newaetech/chipwhisperer-husky/(threads)

Thread 7 (2025-02-27):

GLITCH_HP performance

lujji, 2025-02-27:
I'm trying to figure out why HP glitch has almost no effect on my targets. I probed signals on gate resistors R93 and R88 respectively.

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

5MHz on R93 (GLITCHLP) looks ok:
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

However on R88 the signal is quite distorted:
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

At higher frequencies it is completely unusable:
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

It seems that FPGA doesn't have enough juice to drive the gate of the high-power mosfet. Perhaps a gate-driver is required, or at least connecting a few IOs in parallel?

jpcrypt, 2025-02-27:
The HP MOSFET will take longer to switch, by definition. This will also depend on your target. This is why we have both LP and HP, to give you flexibility. Note that you can also turn both of them on simultaneously. If you drive the glitch long enough then you should see it fully turn on.

jpcrypt, 2025-02-27:
Also FYI some of this is discussed here: https://eprint.iacr.org/2016/810.pdf, and in the [Hardware Hacking Handbook](https://nostarch.com/hardwarehacking).

Thread 8 (2025-02-27):

UART trigger bug

lujji, 2025-02-27:
I'm trying to trigger on UART pattern [0x11, 0xee] (STM32 bootloader Read command).

Setup:
``` python
import chipwhisperer as cw

scope = cw.scope(name='Husky')
scope.default_setup()

scope.io.tio1 = 'serial_tx'
scope.io.tio2 = 'serial_rx'
scope.io.pdic = 'high'
scope.scopetype.usart.init(38400, 1, 'even')
scope.scopetype.usart.timeout = 2000

scope.trigger.module = 'UART'
scope.trigger.triggers = 'tio1' # tx
scope.UARTTrigger.enabled = True
scope.UARTTrigger.baud = scope.scopetype.usart._baud
scope.UARTTrigger.set_pattern_match(0, [0x11], mask=[0xff])
scope.UARTTrigger.trigger_source = 0
scope.UARTTrigger.rules_enabled = [0]

scope.gain.db = 12
scope.adc.samples = 1024
scope.adc.presamples = 0
scope.adc.lo_gain_errors_disabled = True
```

Test code:
``` python
# scope.scopetype.usart.flush()
scope.arm()
scope.scopetype.usart.write([0x11, 0xee])
scope.capture()
print(scope.UARTTrigger.matched_pattern_counts)
```

This works perfectly fine, however if I change the pattern to `[0xee]` in `set_pattern_match()` all of a sudden trigger stops working and I start getting timeouts!
```
(ChipWhisperer Scope WARNING|File _OpenADCInterface.py:732) Timeout in OpenADC capture(), no trigger seen! Trigger forced, data is invalid. Status: 13
(ChipWhisperer Scope WARNING|File _OpenADCInterface.py:732) Timeout in OpenADC capture(), no trigger seen! Trigger forced, data is invalid. Status: 12
```

jpcrypt, 2025-02-27:
It works for me (with no target attached).

My guess is that you have a target attached, but you've reversed the tio1/tio2 directions -- for our targets, tio1 is Tx and tio2 is Rx. So you may have contention on the tio1 line. You could confirm with a logic analyzer.

Re-open the issue if I'm wrong.

lujji, 2025-02-28:
@jpcrypt target is a custom board where TX is indeed routed to tio1. However, since I'm triggering from TX I believe the target board is irrelevant. I have just disconnected everything from the husky and running the code from the above with pattern set to `0xee` always results in a timeout.

lujji, 2025-02-28:
Checked with a scope on tio1 just to make sure - serial data is being generated as expected. It seems like there's something special about the 0xEE byte..
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

jpcrypt, 2025-02-28:
> edit: I think I've narrowed it down to parity setting - when parity is set to 'even' it breaks UART trigger

No- it's because by default, the `UARTTrigger` module is set to "no parity":
```
>>> print(scope.UARTTrigger)
enabled                = True
baud                   = 38432.64699673976
data_bits              = 8
stop_bits              = 1
parity                 = none
accept_parity_errors   = False
sampling_clock         = 39764270.7824707
trigger_source         = rule #0
rules_enabled          = [0]
rules                  = [{'rule': 0, 'patt': bytearray(b'\x00\x00\x00\x00\x00\x00\x00\x11'), 'mask': bytearray(b'\x00\x00\x00\x00\x00\x00\x00\xff')}]
matched_pattern_counts = [15, 0, 0, 0, 0, 0, 0, 0]
```
You need to set `scope.UARTTrigger.parity` to 'even'.
(alternatively, set `scope.UARTTrigger.accept_parity_errors = True` and parity will be ignored)

lujji, 2025-02-28:
Ah, I see, `UARTTrigger` has it's own parity setting independent of built-in usart - now it works as expected, thank you!

jpcrypt, 2025-02-28:
They are 100% independent and unaware of each other -- that's a feature, not a bug, to better support the general case i.e. triggering on UART traffic where Husky is neither the sender nor the receiver.

Closed 2025-02-27.

Thread 9 (2025-03-07):

CW functionality in MPSSE mode

lujji, 2025-03-07:
Is it possible to use chipwhisperer functionality in MPSSE mode while debugging the target ? This is what I've tried so far:

```
scope = cw.scope(name='Husky')
scope.enable_MPSSE(1, husky_userio='jtag') # 'swd' does not work
scope.dis()
```
At this point I can connect to the target via openocd, however after reconnecting to husky with `scope = cw.scope(name='Husky')` openocd can no longer connect to target:
```
Open On-Chip Debugger 0.12.0
Licensed under GNU GPL v2
For bug reports, read
        http://openocd.org/doc/doxygen/bugs.html
none separate

Info : FTDI SWD mode enabled
swd
Info : Listening on port 6666 for tcl connections
Info : Listening on port 4444 for telnet connections
Info : clock speed 2000 kHz
Error: Error connecting DP: cannot read IDR
```
The documentation lists some of the [limitations](https://chipwhisperer.readthedocs.io/en/latest/debugging.html#feature-limitations) in MPSSE mode, however from what I understand they are only related to certain IOs and stream mode.

colinoflynn, 2025-03-07:
Are you running this on Windows by chance? That has an additional [limitation](https://chipwhisperer.readthedocs.io/en/latest/debugging.html#windows-specific-limitations) that only one process can attach at a time.

Otherwise I think you *shouldn't* disconnect:
```
scope.dis()
```

This is required on Windows due to the limitation. Alex can confirm however as it's been a while since I ran this, but wanted to check on the Windows question first as that would be the limitation of the OS here.

lujji, 2025-03-07:
I'm running on linux. Tried without calling `scope.dis()` - same result.

alex-dewar, 2025-03-07:
I remember this working at one point, but this might've been broken when fixing something else. I probably won't have time to look into this for quite a while, so I'm going to update the documentation to note that simultaneous use of CW and MPSSE might not work.

colinoflynn, 2025-03-07:
I don't remember 100% if I ever did it either - the main use case of MPSSE was for programming targets w/o bootloaders, and not simultaneous debugging. From memory the timing could be tricky.

What target is this on too?

lujji, 2025-03-07:
Target is stm32f4 (custom board), swd connected as follows:
```
SWDIO -> JTAG_TMS
SWCLK -> JTAG_TCK
```

Newer revision of factory bootloader has multiple places where it checks for readout protection and I'm trying to figure out the timings for the attack by setting multiple breakpoints and analyzing power traces.

I had the same "cannot read IDR" error when I tried setting `husky_userio='swd'` instead of `jtag`  - something weird was happening on SWDIO line when device was replying to SWD commands.

lujji, 2025-03-07:
Ok, I think I found a solution - calling `scope.io.cwe.setAVRISPMode(1)` after re-connecting to husky seems to fix SWD.

Closed 2025-03-08.
