newaetech/chipwhisperer-husky/schematic/NAE-CWLITE-HUSKY-03.PDF

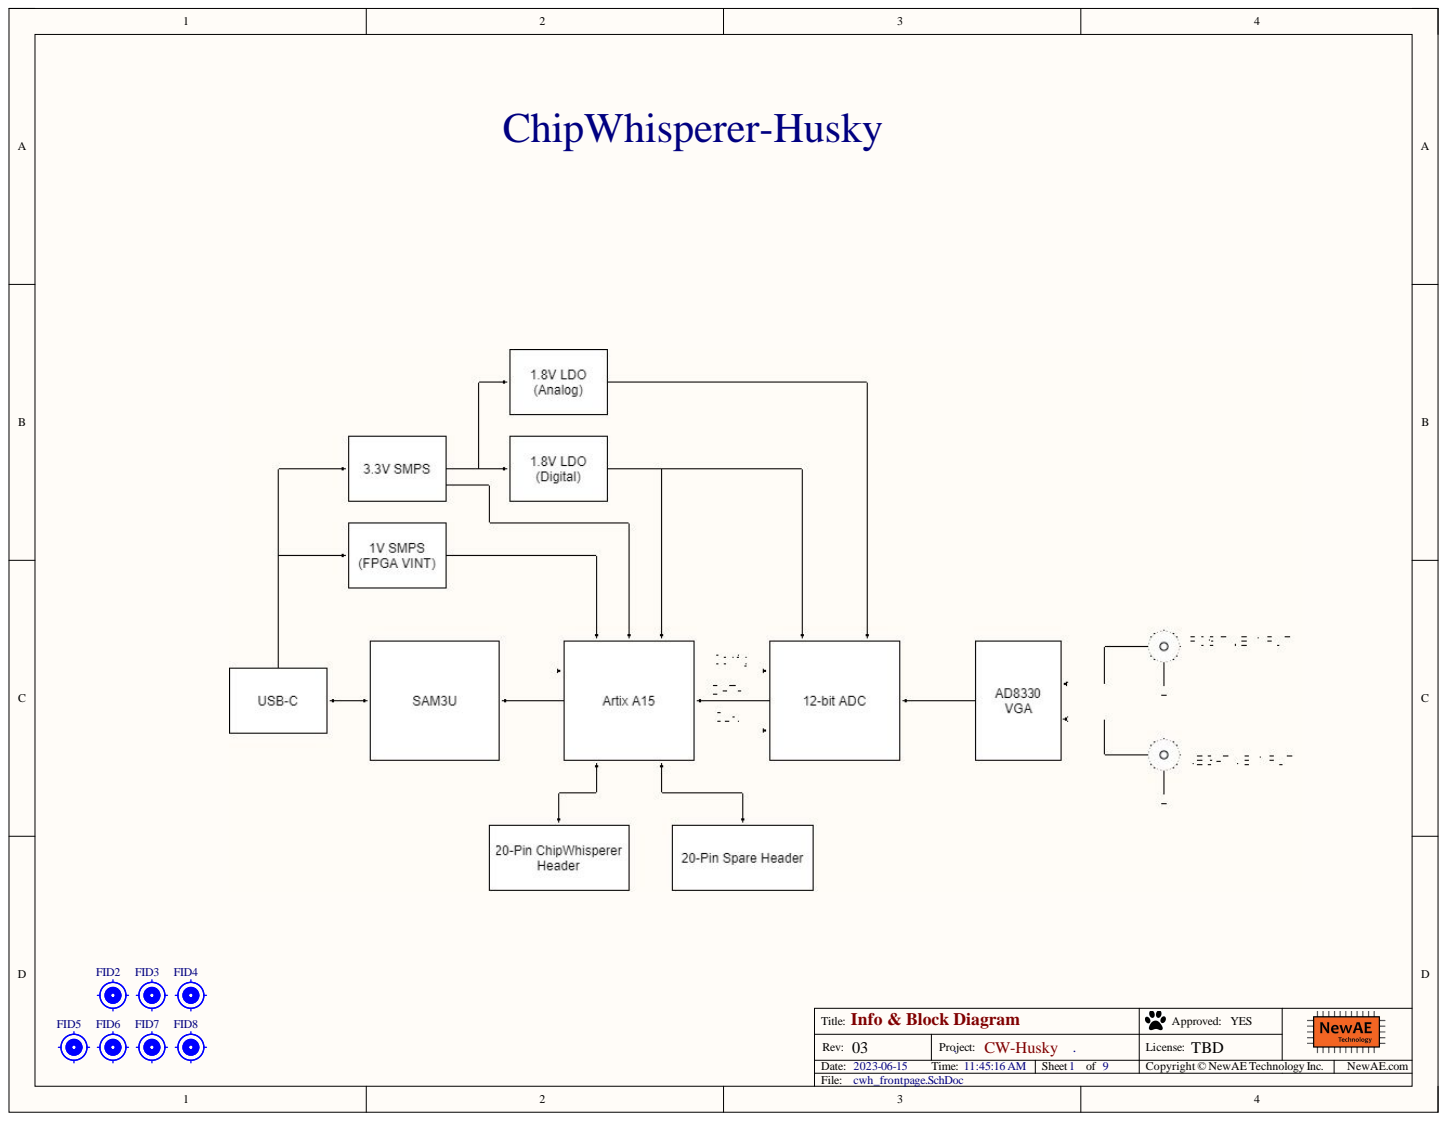
[picture p2: page 1]

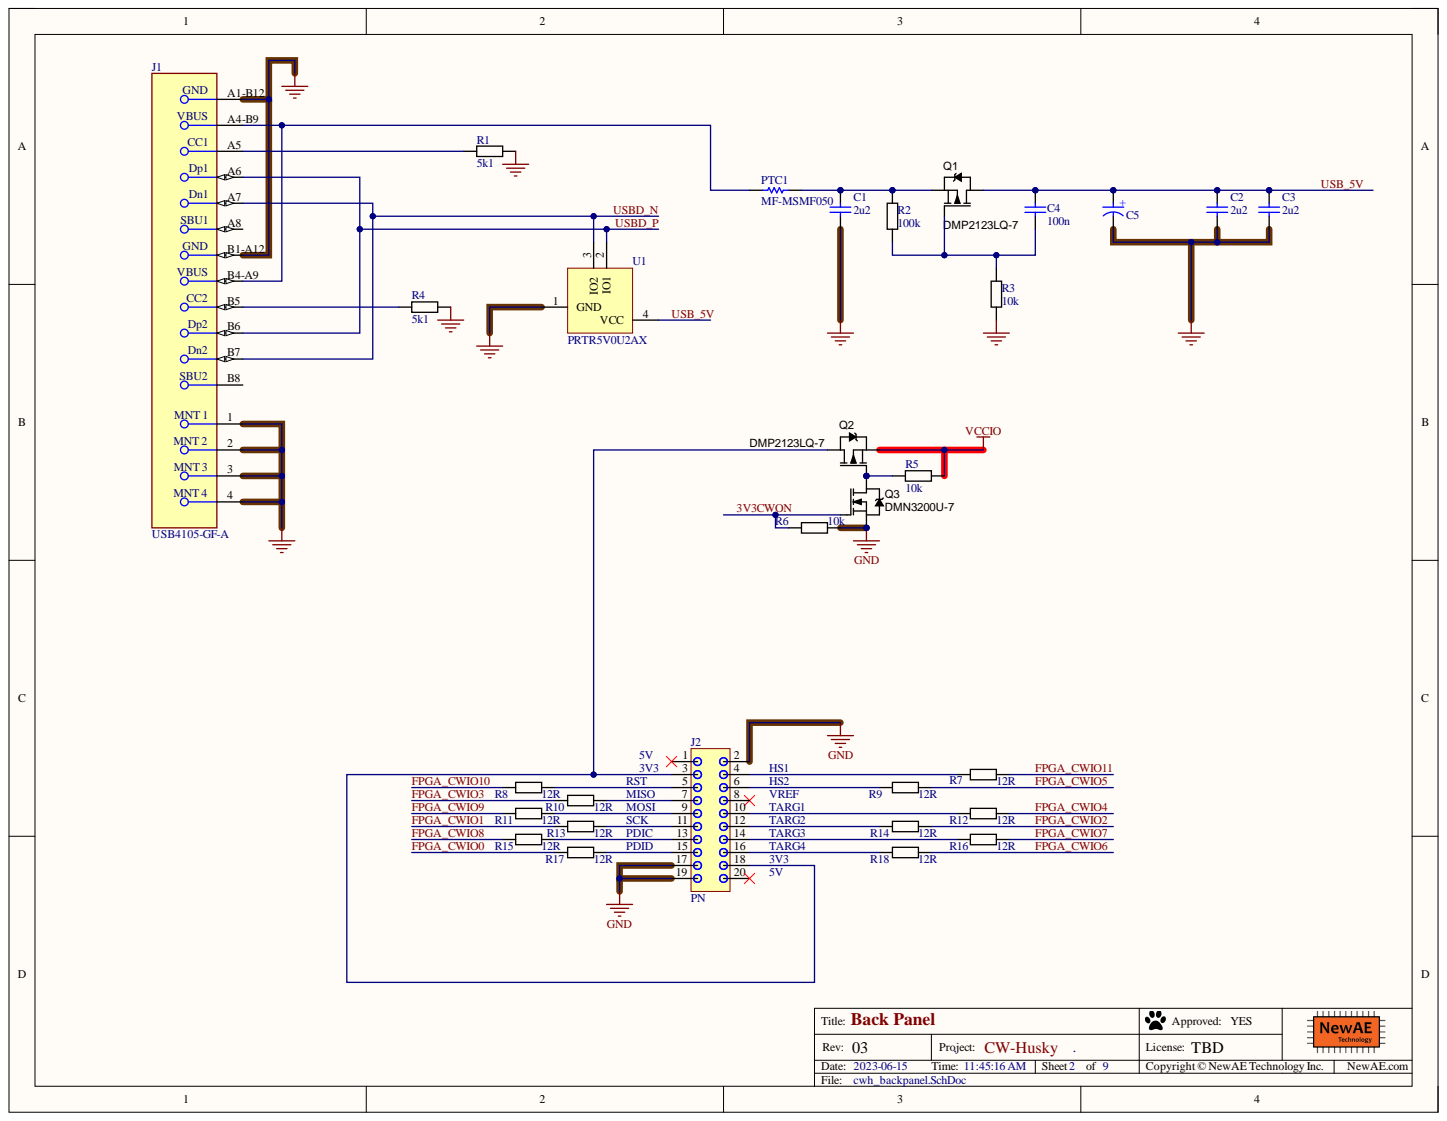
[picture p3: page 2]

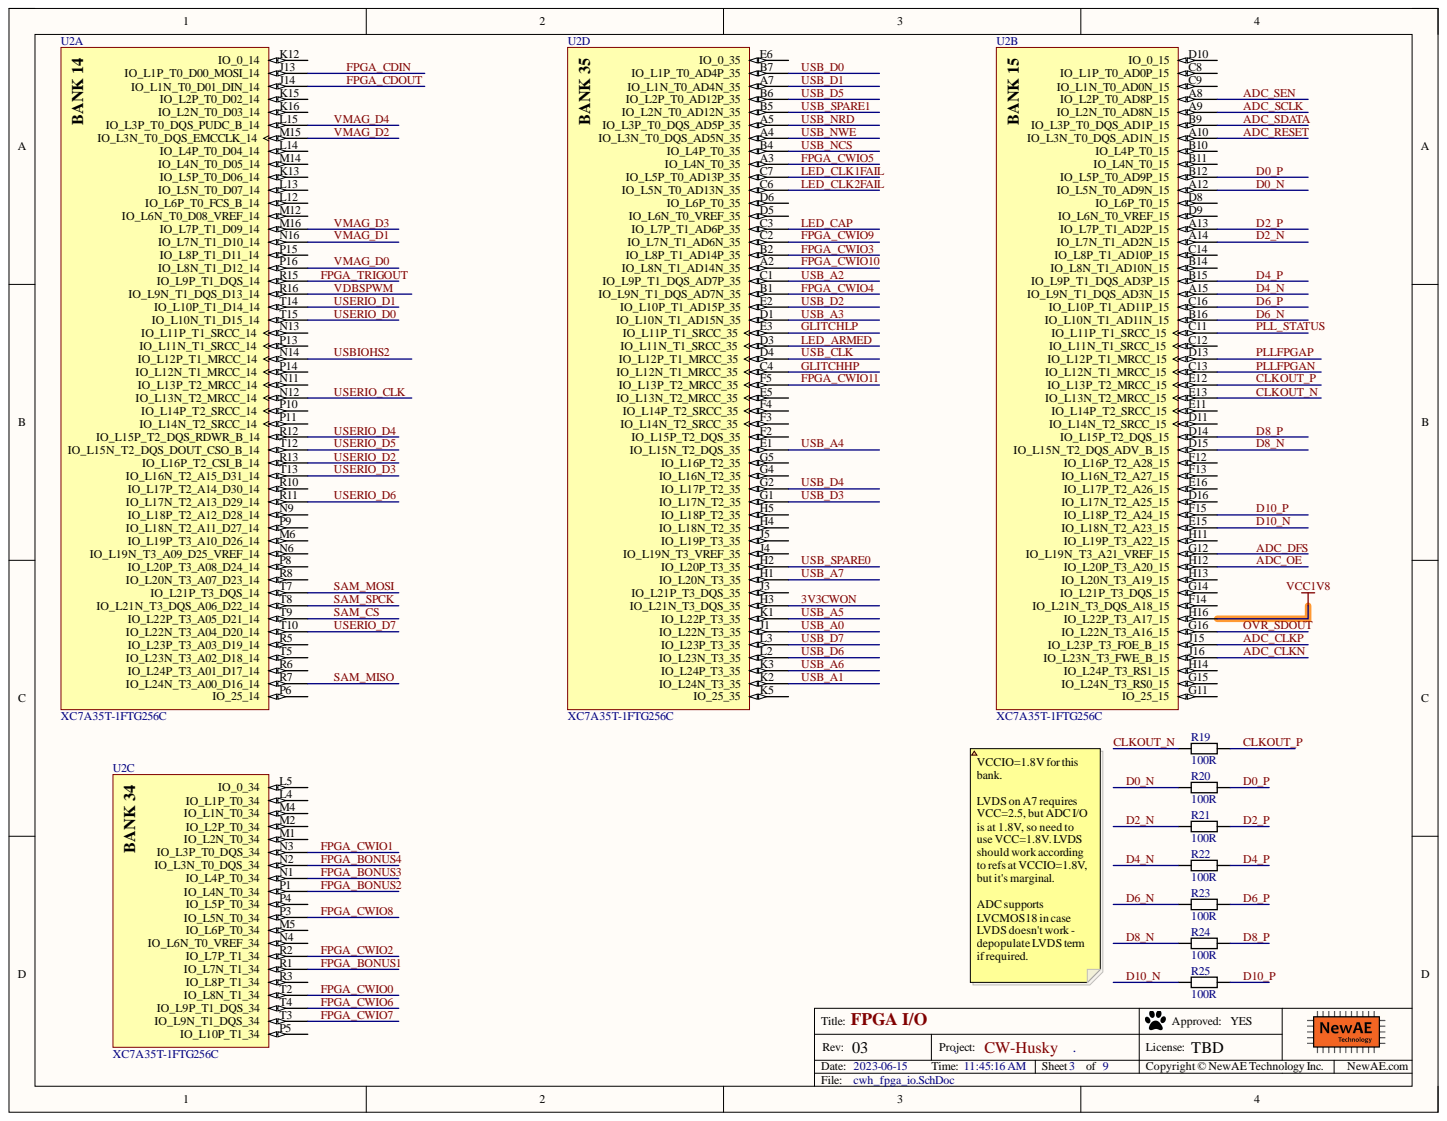
[picture p4: page 3]

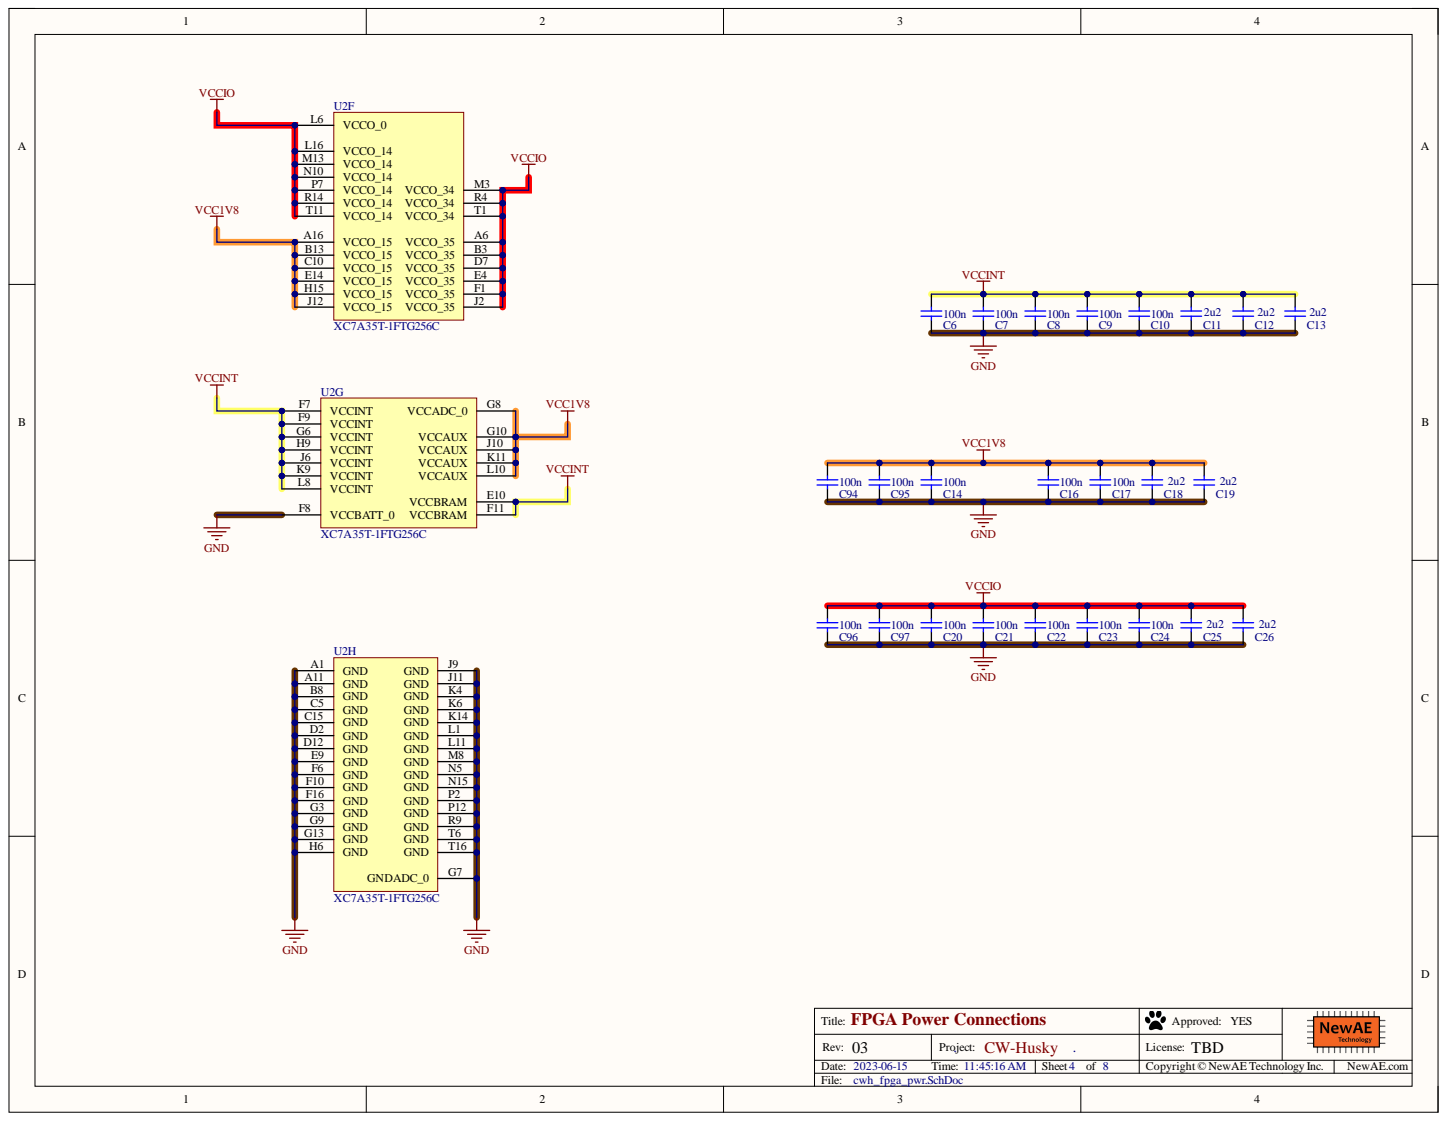
[picture p5: page 4]

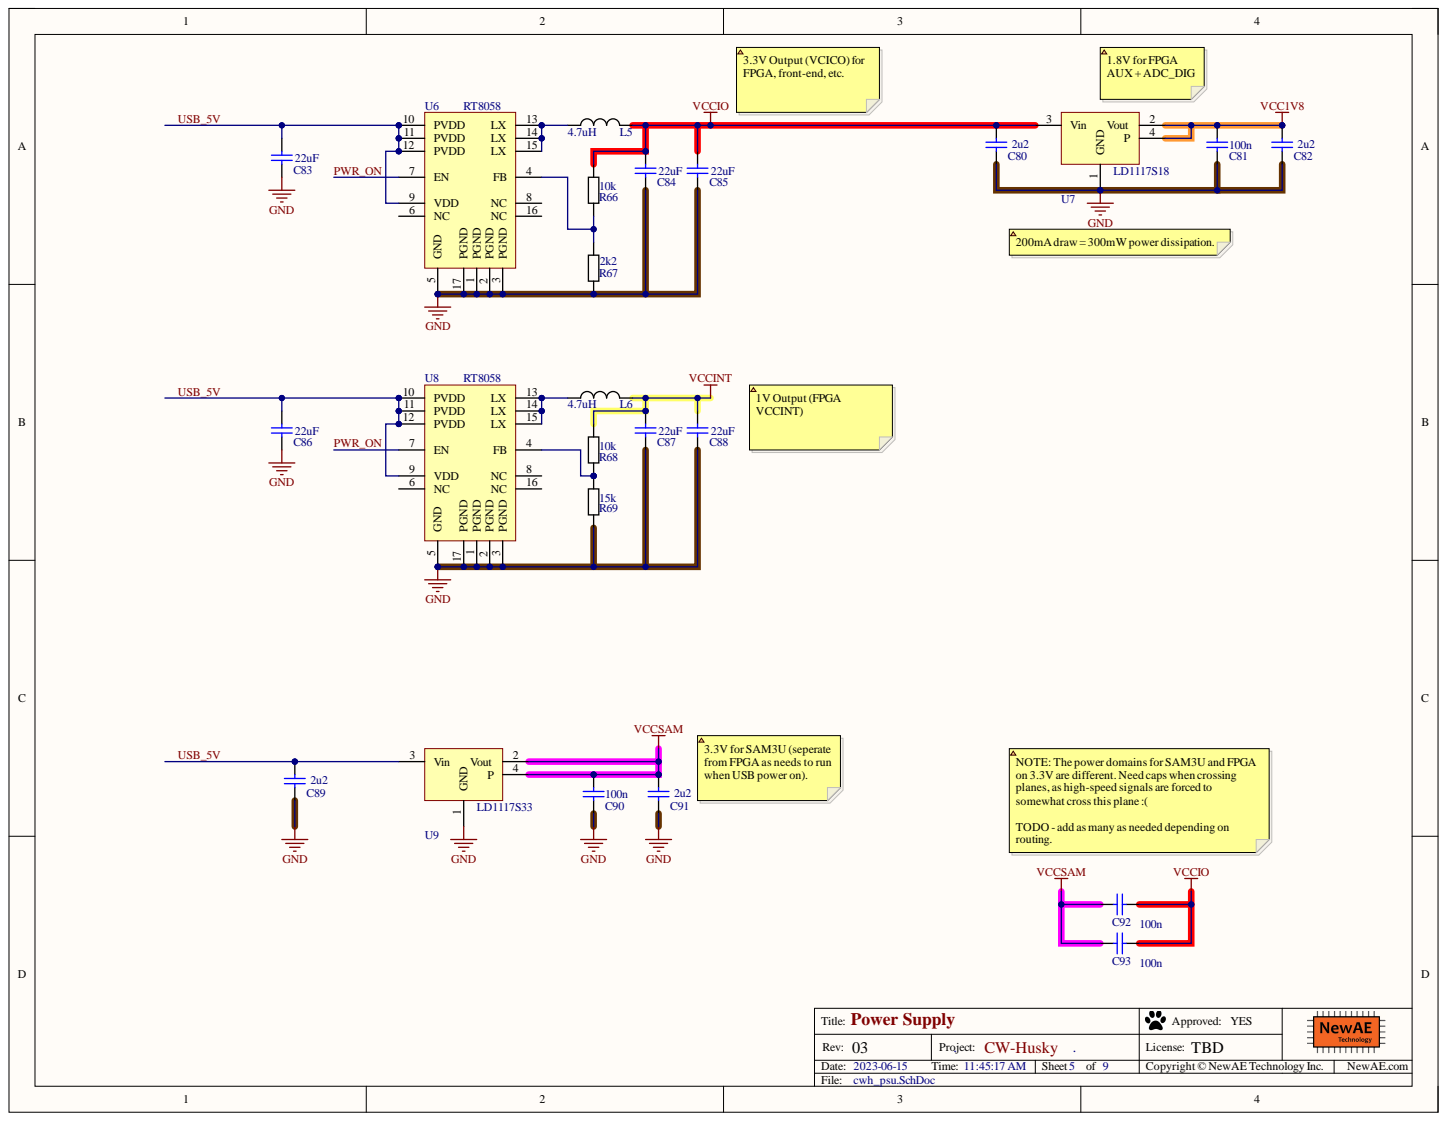
[picture p6: page 5]

3.3V Output(VCICO) for
FPGA, front-end, etc.

3.3V for SAM3U (seperate
from FPGA as needs to run
when USB power on).

NOTE: The power domainsfor SAM3U and FPGA
on 3.3V are different. Need caps when crossing
planes, as high-speed signals are forced to
somewhat crossthis plane :(

TODO - add as many as needed depending on
routing.

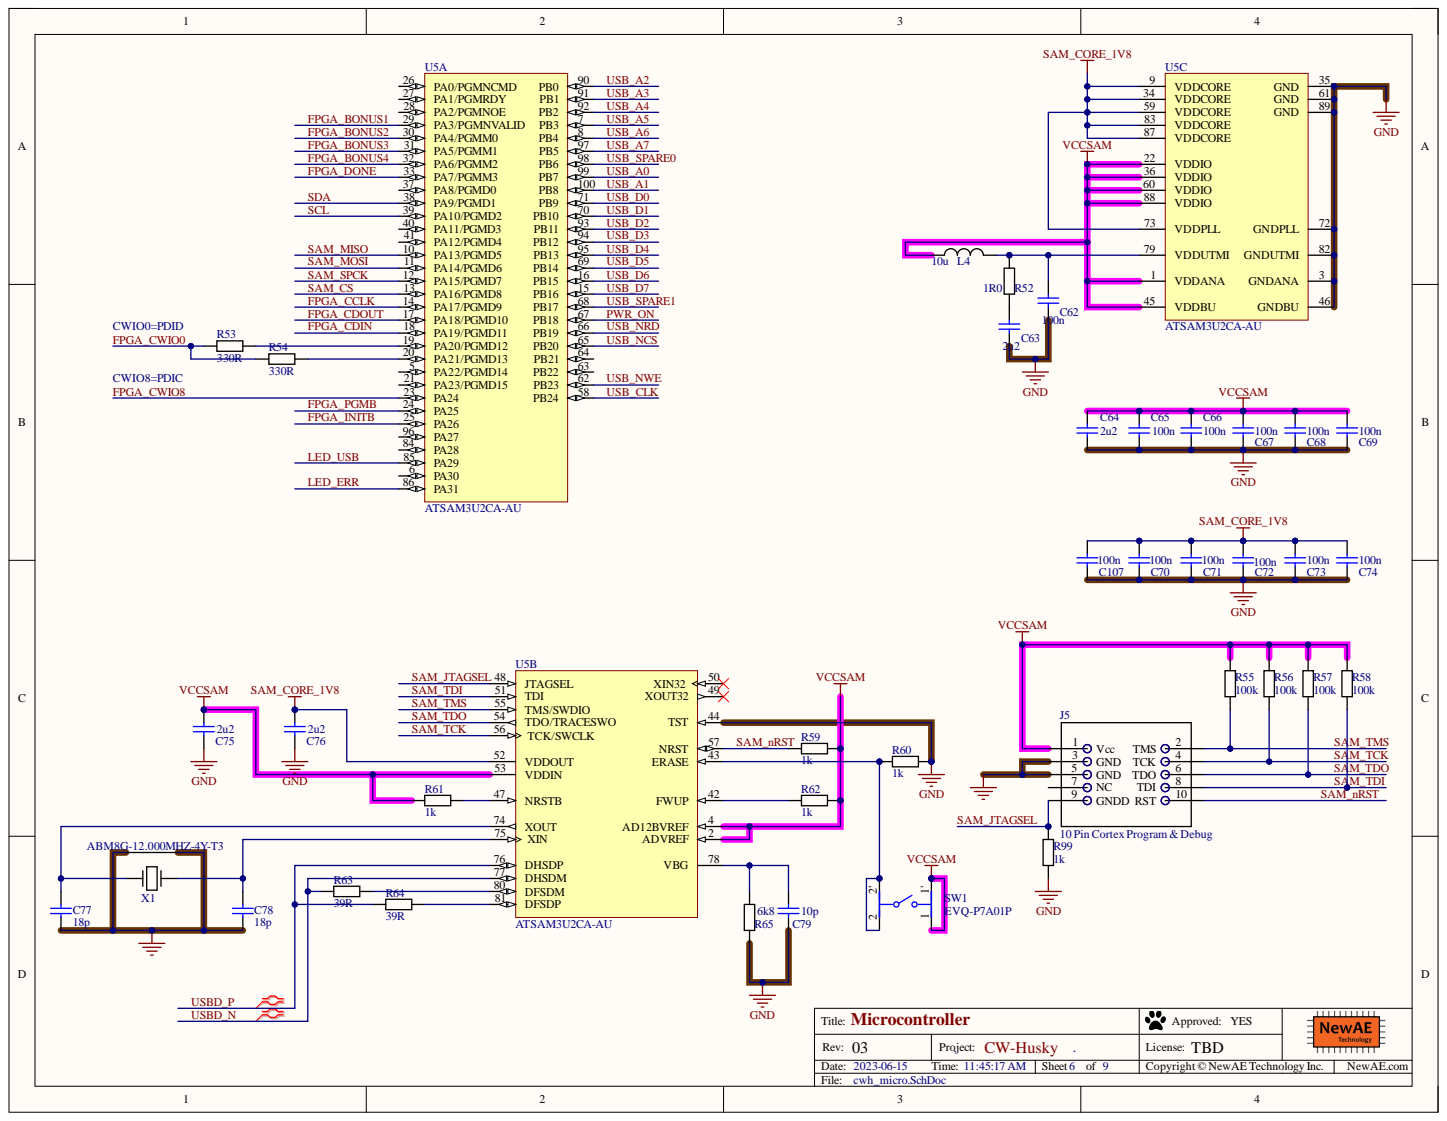
[picture p7: page 6]

DHSDP 76

R63 | DFSDM 80

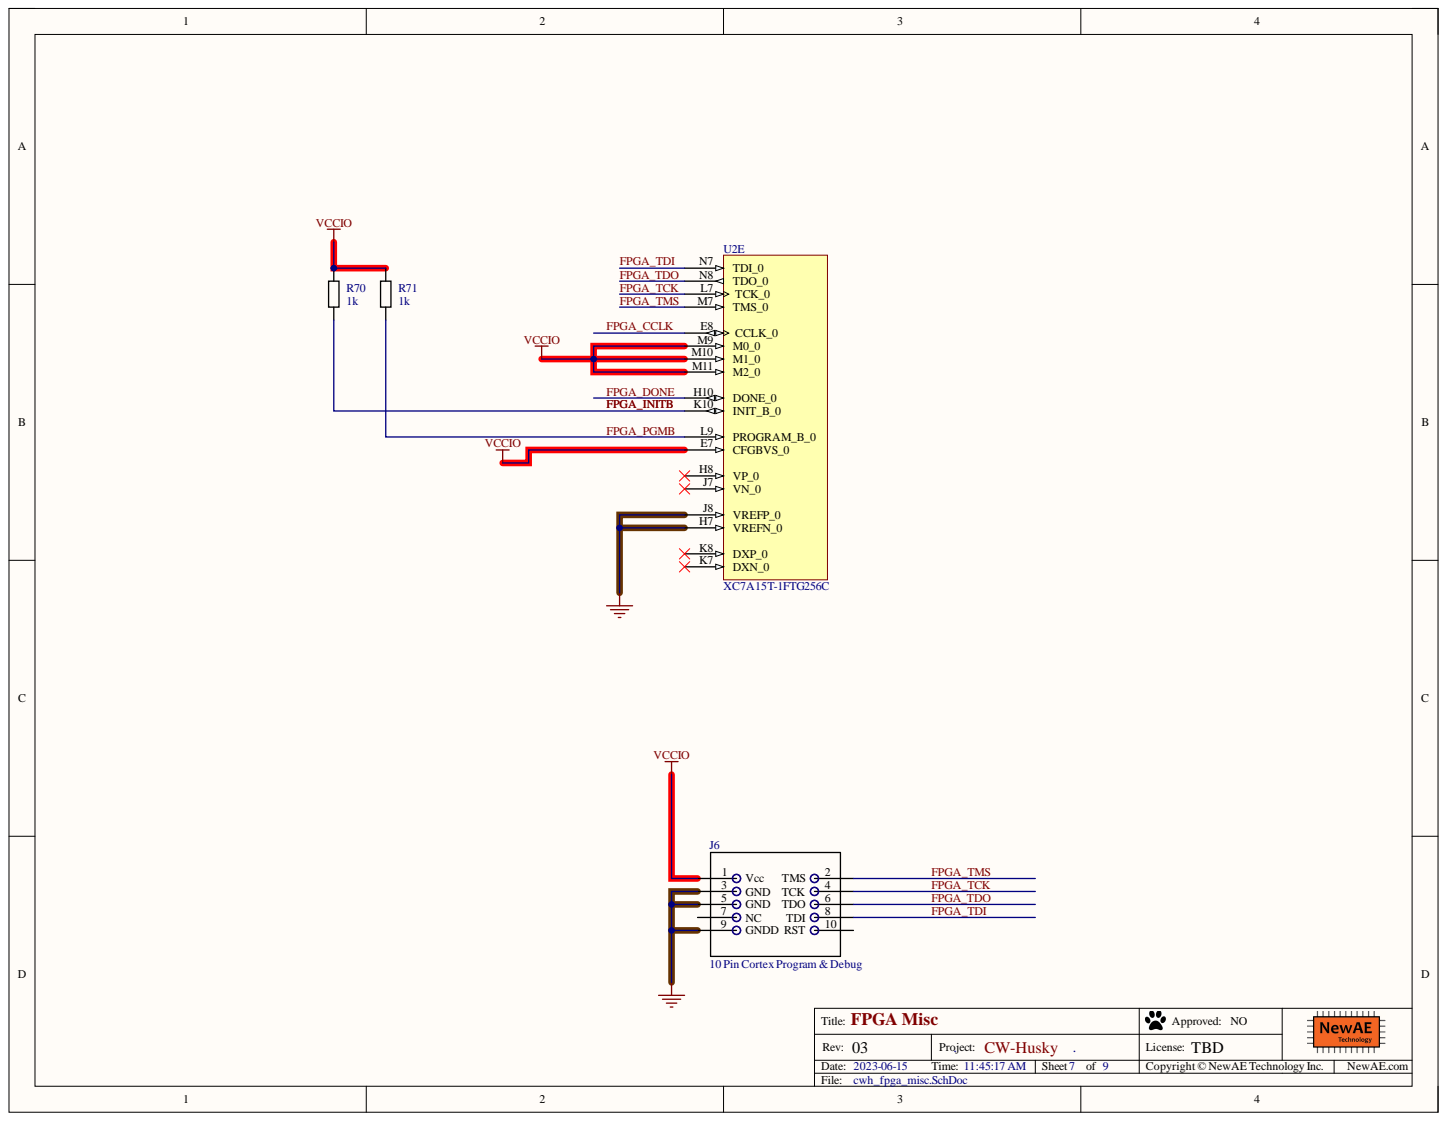
[picture p8: page 7]

FPGA_CCLK VCCIO

FPGA_PGMB

CFGBVS_0 E7 PROGRAM_B_0 L9 VP_0 H8

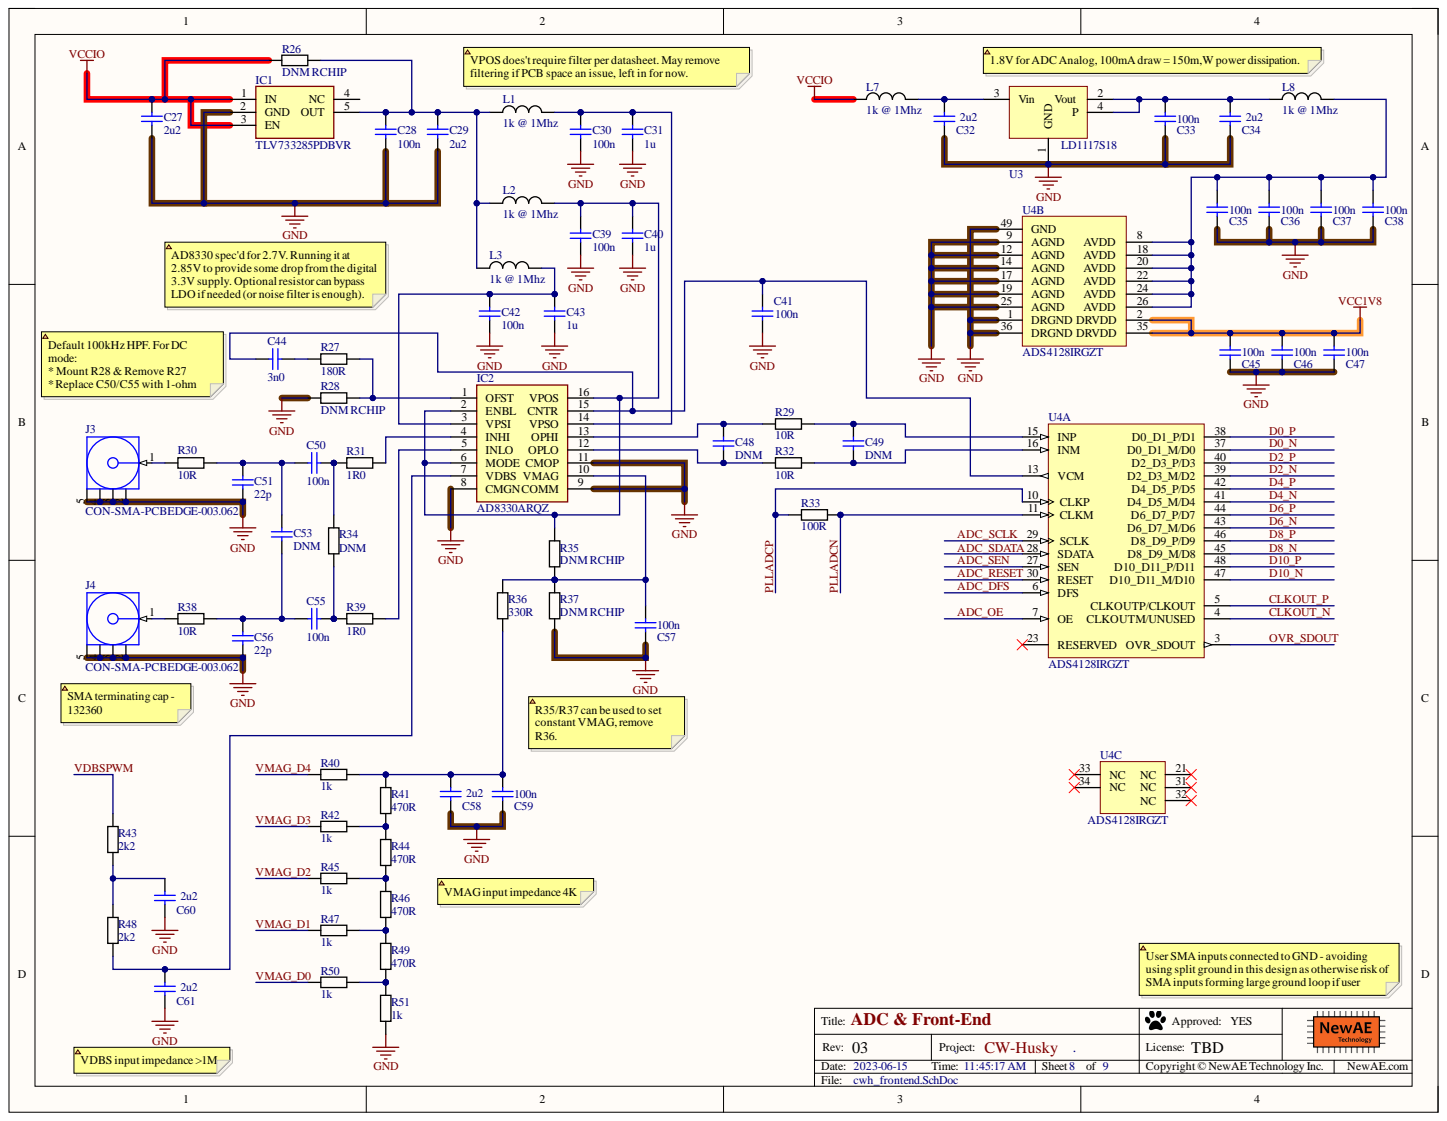
[picture p9: page 8]

VPOS does'trequire filter per datasheet. May remove
filtering if PCB space an issue, left in for now.

1.8V for ADC Analog, 100mAdraw = 150m,W power dissipation.

IC1 | DNM RCHIP
IN 1

AD8330 spec'd for 2.7V. Running it at
2.85V to provide some drop from the digital
3.3V supply. Optionalresistor can bypass
LDO if needed (or noise filter is enough).

Default 100kHz HPF. For DC
mode:
* Mount R28 & Remove R27
*Replace C50/C55 with 1-ohm

R35/R37 can be used to set
constant VMAG, remove

User SMAinputs connected to GND - avoiding
using split ground in this design as otherwise risk of
SMAinputsforming large ground loop if user

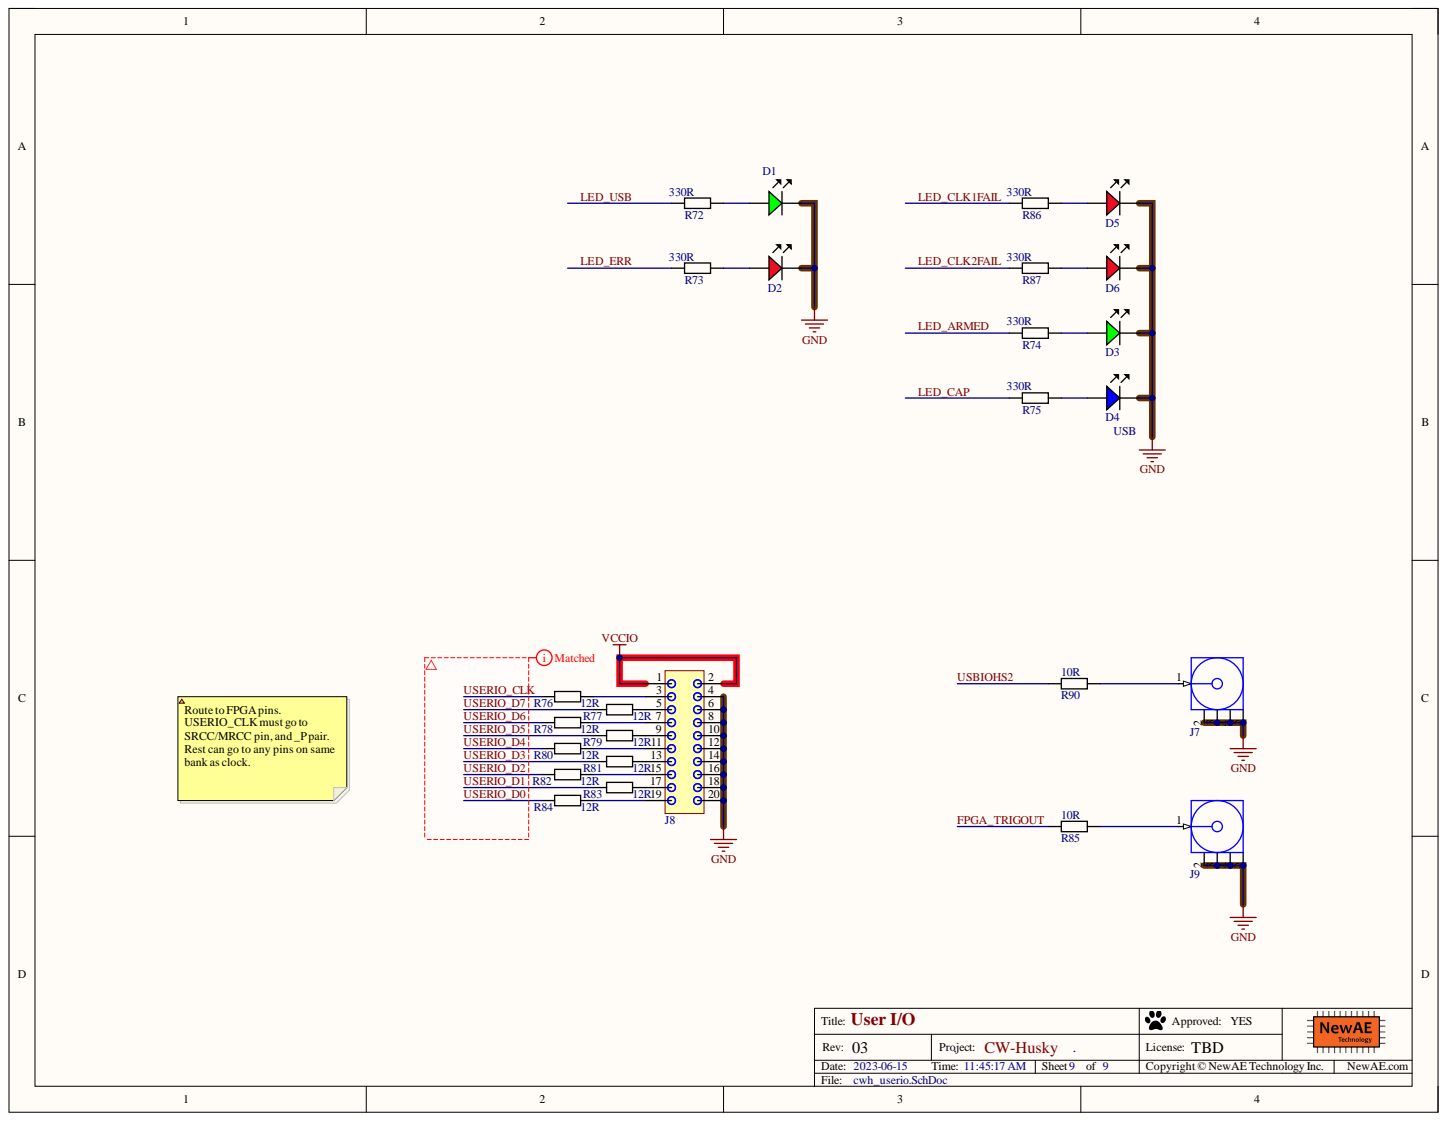
[picture p10: page 9]

Route to FPGApins.
USERIO_CLK must go to
SRCC/MRCC pin, and _Ppair.
Rest can go to any pins on same
bank as clock.

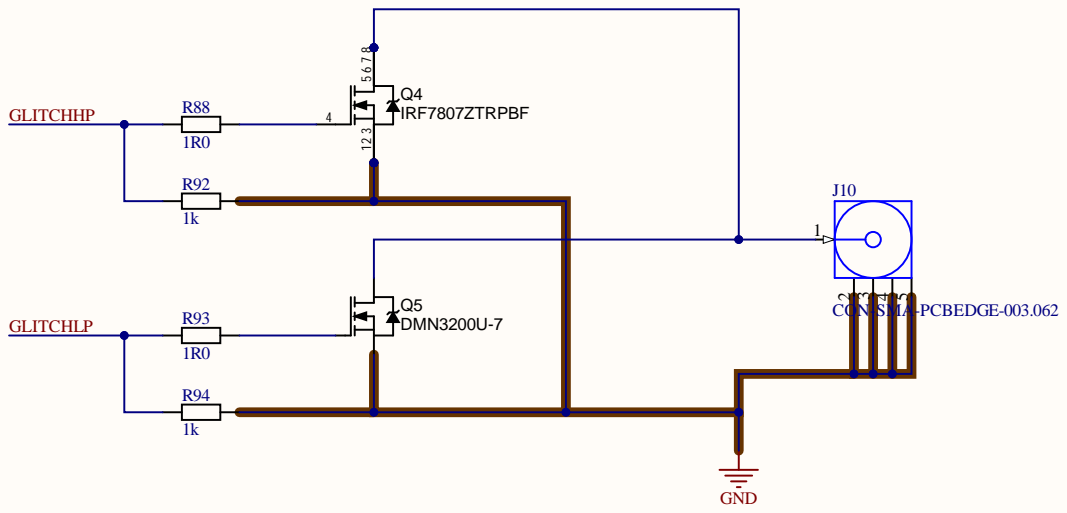
[picture p11: page 10]

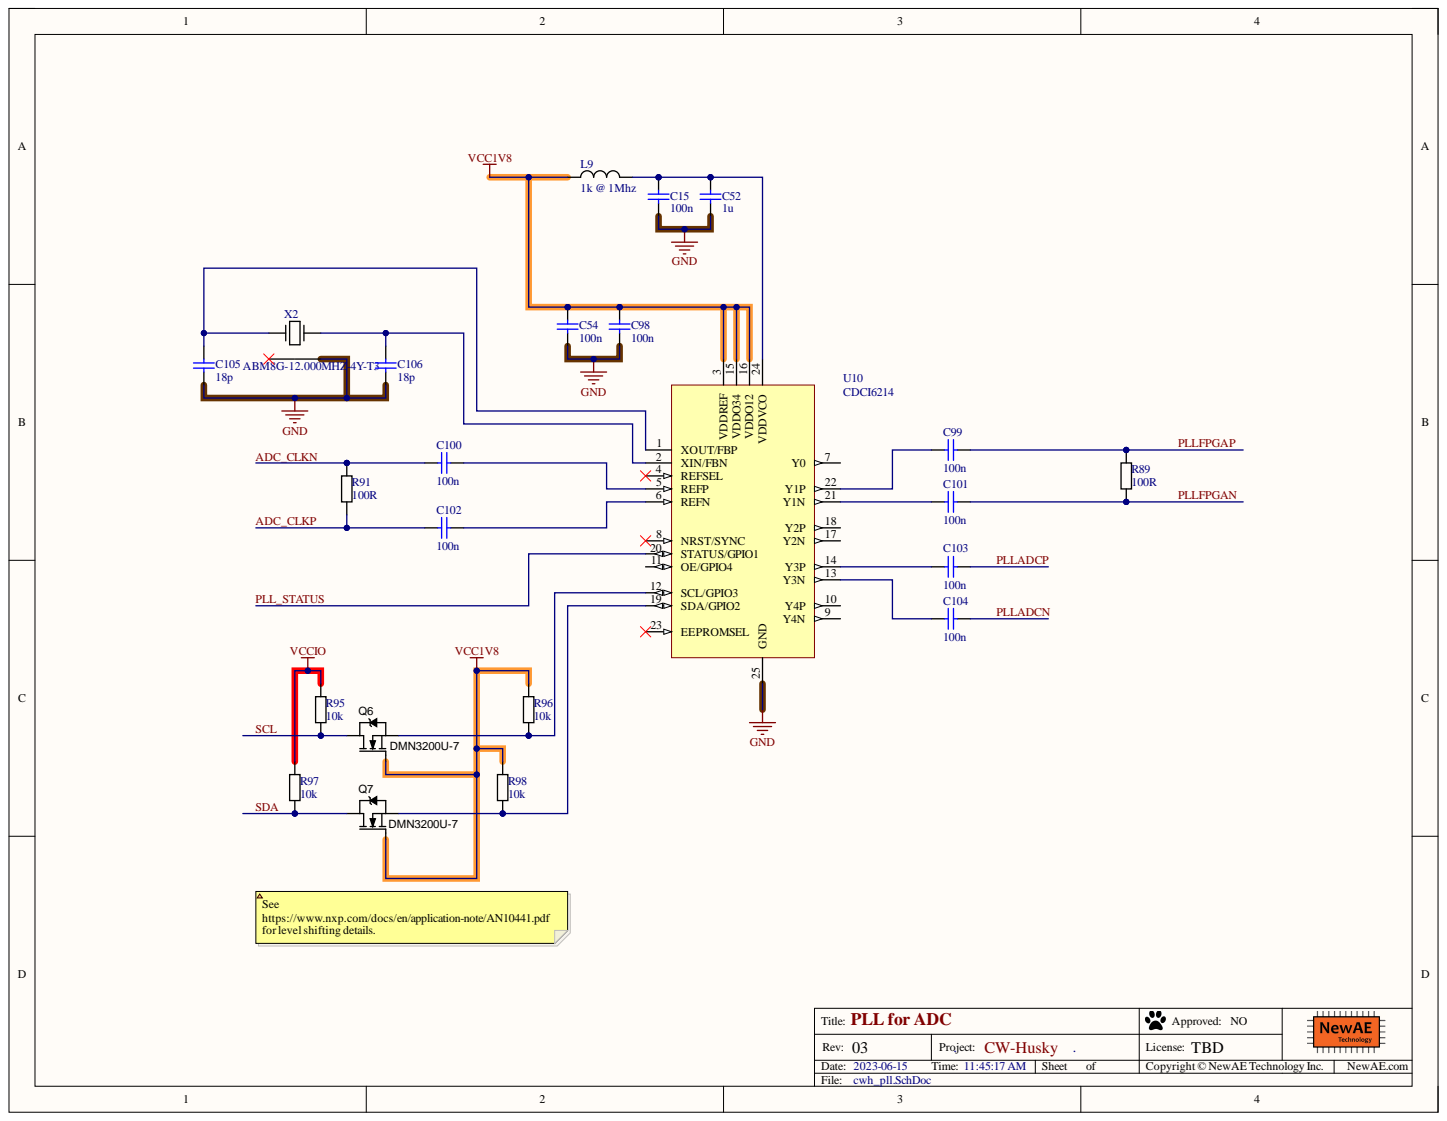
[picture p12: page 11]

OE/GPIO4 11

SDA/GPIO2 19

See
https://www.nxp.com/docs/en/application-note/AN10441.pdf
for levelshifting details.
