newaetech/chipwhisperer-husky/ChipWhisperer-Husky/src/naeusb_husky.h

#pragma once
#include "naeusb/naeusb.h"
#include "naeusb/naeusb_openadc.h"

#define REQ_MEMSTREAM 0x14
#define REQ_FAST_FIFO_READS 0x27
#define REQ_CDCI6214_DATA 0x29
void husky_register_handlers(void);
