newaetech/chipwhisperer-husky/(commit log)

2021-02-11 Working FPGA prog
    [Makefile.hal]
2021-02-15 Fix FPGA programming pins
    [main.c]
2021-02-15 Fix CW-Husky name, power pin
    [cw521.h]
2021-02-17 Fix merge issues, update FPGA addr pins
    [cw521.h, main.c]
2021-02-17 Add USB/err LEDs
2021-02-17 Add spi initial implementation (not working yet)
    [cw521.h, spi_driver.c, spi_driver.h]
2021-02-17 More WIP spi
2021-02-17 Working UART (had to remove printf)
2021-02-17 SPI test, merging in from main
2021-02-18 Working SPI
2021-02-18 Add ADC spi read/write commands
2021-02-23 Fix timing & address pin stuff
    [main.c]
2021-03-11 Add fast SMC timing option for streaming mode.
    Boosts FPGA reading times from 20 cycles for 32 bytes to 12 cycles for
    32 bytes.
    Can only be used for ADC sample reads (other register reads won't work);
    must manually revert to "slow" read mode when done reading the samples.
    [main.c]
2021-03-26 Working I2C with pll chip
2021-04-09 Working PLL/I2C
2021-04-19 Fix I2C
2021-04-19 Remove probably-breaking ADC/SPI code
2021-04-19 Remove stall when no PLL data - this gets caught by Python API instead which is easier to debug
2021-04-19 Disable SPI (helps with heat)
2021-04-20 Fix hard fault issue?
    [main.c]
2021-05-04 Make stream USB wait for ready pin to go high
2021-08-26 Working avr programming on husky (undef printf)
2022-04-01 Add target SPI programming on CW-Husky
2022-09-01 Add schematic
2022-09-07 clear old hal, update naeusb, add firmware autobuild
    [Makefile.hal]
2023-02-01 Add sam3u led errors
    [conf_usb.h, naeusb_board_config.h, ui.c]
2023-06-15 Add rev03 schematic
2023-06-15 Remove rev02 schematic
2026-11-04 Working CDC and SW flow control. Make ERROR LEDs blink if small error
    CDC very annoying due to DMA disable in usart_dma_read()
